ARTITULE/Stylophone_PCB/README.md

# Stylophone_PCB

A 20 key PCB Stylophone made using the 10 cent CH32V003 RISC-V microcontroller. It uses the FM8002A to amplify the signal to drive a small speaker. The whole thing is USB powered and functions like the real thing.

I made this to get better with audio circuits and also as a part of my week 3 submission to Half Life.

| Front Picture | Back Picture |
|---|---|
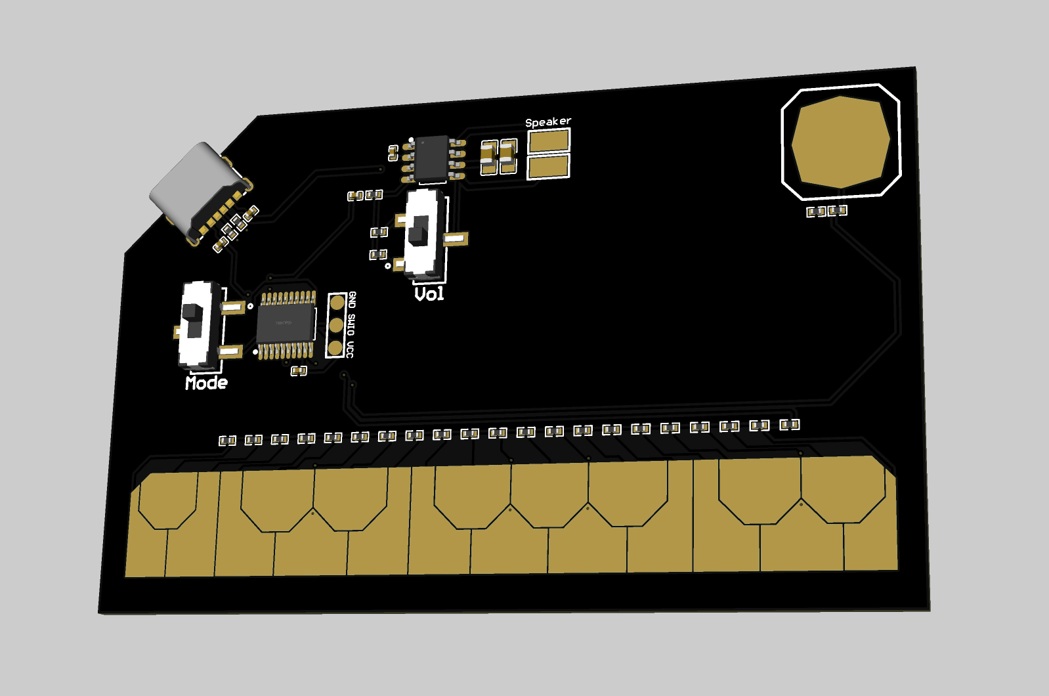
[picture p1: Pic/PCB_v1.0_Front.png]
front
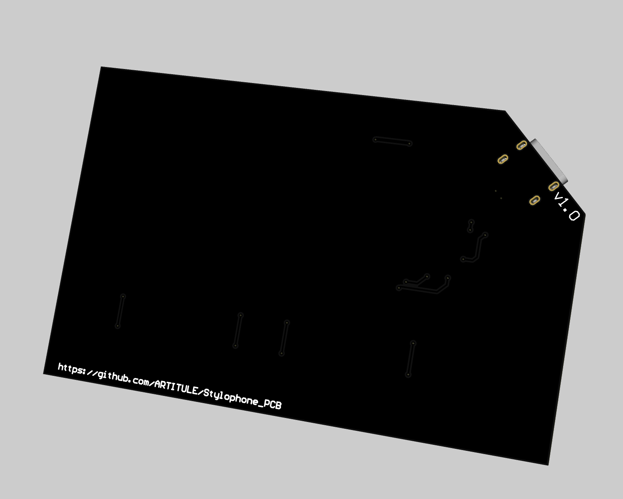
[picture p2: Pic/PCB_v1.0_Back.png]
back
|  |  |

## PCB Design

The PCB is a simple 2 Layer design. The project is powered with the Type-c USB port and uses the CH32V003 to read the key inputs and play audio accordingly. A resistor ladder is used to read all of the key presses. All of the parts are meant to be soldered to the PCB. All of the PCB files can be found in the [PCB_Files](/PCB_Files/) folder. There you can also find the BOM for the PCB.

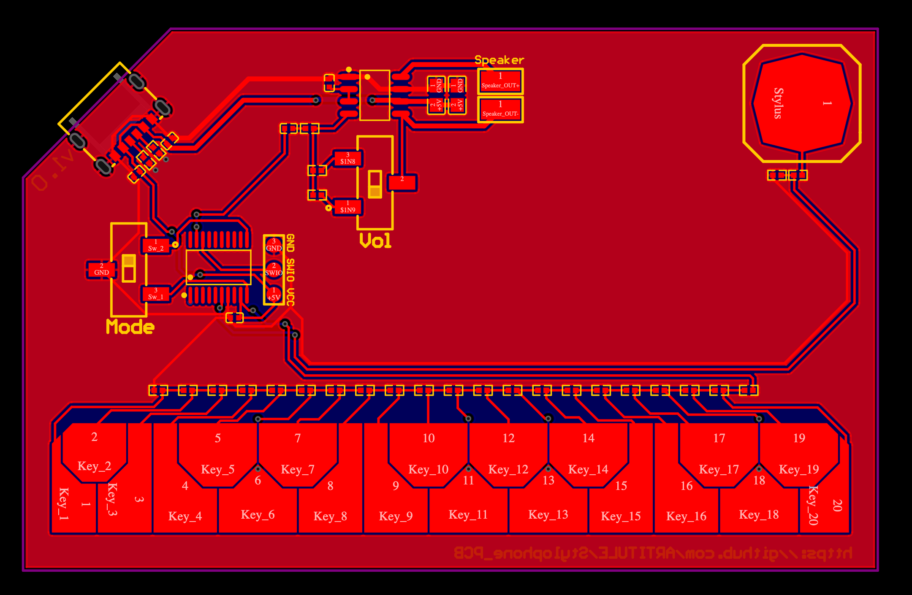
[picture p3: Pic/PCB_PCB1_2026-10-25.png]
PCB


For anyone interested here is the schematic:
Schematic

## Assembly

After soldering all of the SMD components to the PCB the last step is to solder the speaker to the two pads under the "Speaker" text.

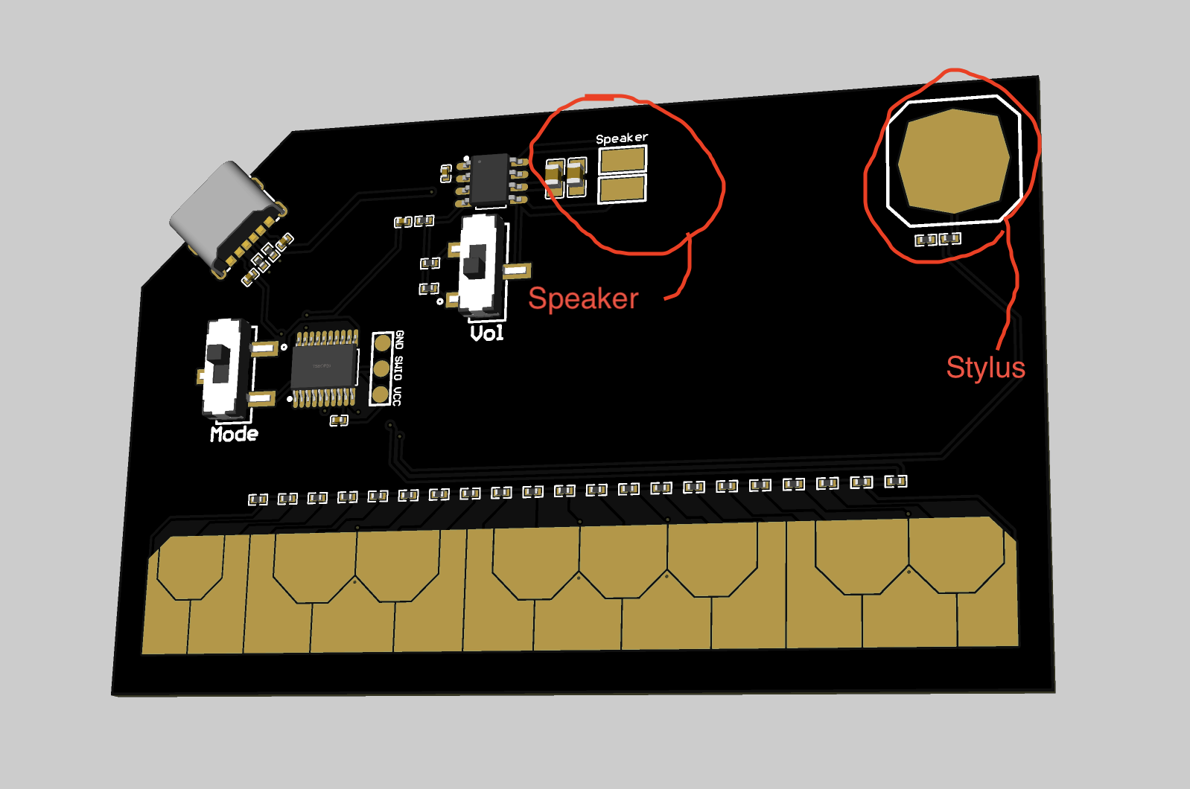
[picture p4: Pic/Speaker_Pointed.png]
speaker_pointed


After that just connect a crocodile clip or a stylus to the Stylus pad and enjoy!

## Firmware

One of the crystal pins has been used for the ADC function. Thankfully the PlatformIO Extension takes care of that and you can just upload the code.

All of the code is located in the [src folder](/src/).

## Installation

1. Clone or download the repository.
2. Initialize the PlatformIO extension.
3. Connect the WCH LINK-E programmer.
4. Select the "Stylophone_PCB" environment.
5. Upload the firmware and enjoy!

## BOM

Please note that the Shipping Price is an estimate and that the speaker/alligator clips have a minimum purchasing quantity.

|Item |Qty|Supplier|Cost/item |Total Cost|link |
|---|---|---|---|---|---|
|PCB |1  |JLCPCB  |$4.00 |$4.00 |[JLCPCB](https://jlcpcb.com) |
|SMD Components from LCSC(Please upload the PCB BOM to their website)|1  |LCSC |$11.09(Estimated)|$11.09 |[LCSC](https://www.lcsc.com) |
|8Ohm 2W Speaker (MOQ 6) |6  |Amazon  |$5.99 |$5.99 |[Amazon](https://www.amazon.com/Speaker-Speakers-Compatible-Loudspeaker-Player/dp/B09YGDQV3Z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) |
|Alligator Clips (MOQ 10) |10 |Amazon  |$4.99 |$4.99 |[Amazon](https://www.amazon.com/Alligator-Electrical-Crocodile-Connector-Connection/dp/B096S2JXYW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)|
|Estimated total shipping |1  | | |$20.00 | |
|Estimated TOTAL | | | |$46.07 | |
