ARTITULE/Stylophone_PCB/Pic/3D_Stylophone_PCB_v1.0_Front.png

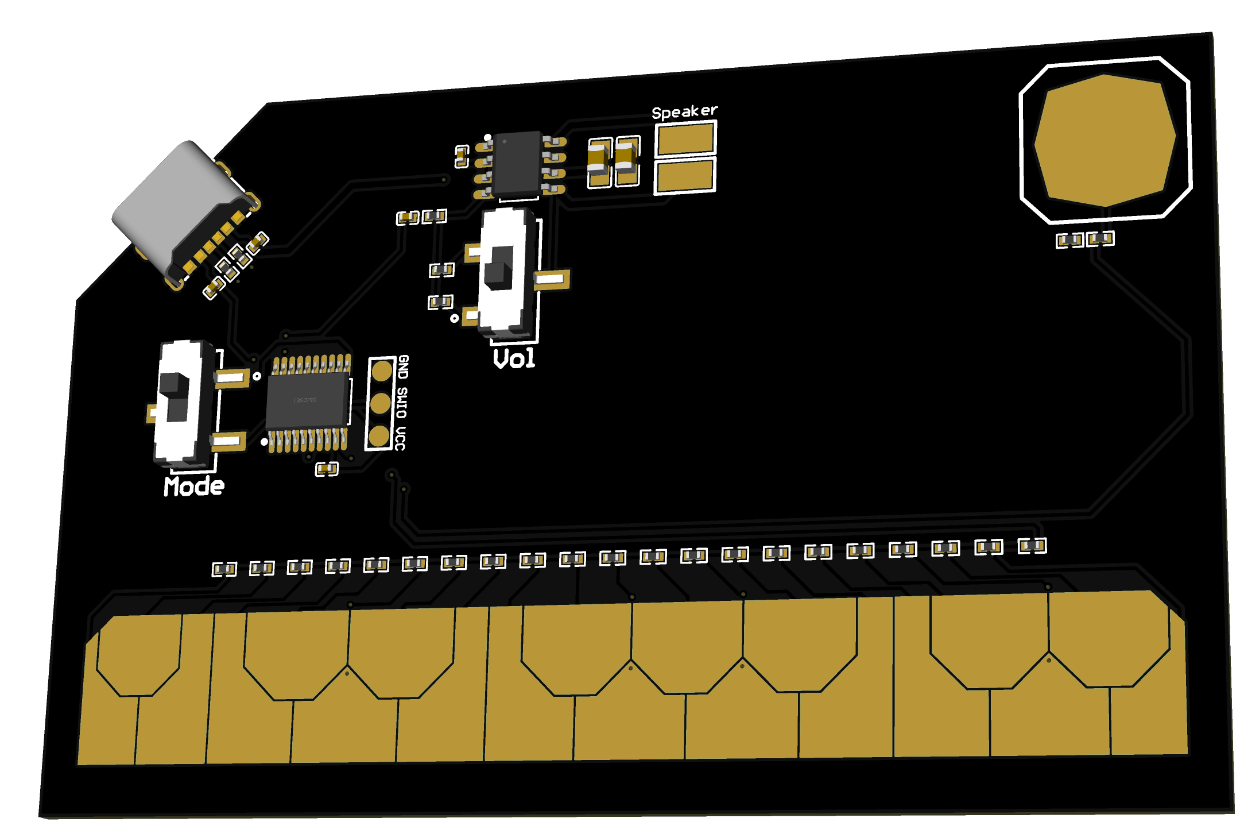
Pic/3D_Stylophone_PCB_v1.0_Front.png
