ARTITULE/Stylophone_PCB/BOM.csv

Item | Qty | Supplier | Cost/item | Total Cost | link
PCB | 1 | JLCPCB | $4.00 | $4.00 | https://jlcpcb.com
SMD Components from LCSC(Please upload the PCB BOM to their website) | 1 | LCSC | $11.09(Estimated) | $11.09 | https://www.lcsc.com
8Ohm 2W Speaker (MOQ 6) | 6 | Amazon | $5.99 | $5.99 | https://www.amazon.com/Speaker-Speakers-Compatible-Loudspeaker-Player/dp/B09YGDQV3Z
Alligator Clips (MOQ 10) | 10 | Amazon | $4.99 | $4.99 | https://www.amazon.com/Alligator-Electrical-Crocodile-Connector-Connection/dp/B096S2JXYW
Estimated total shipping | 1 |  |  | $20.00
Estimated TOTAL |  |  |  | $46.07
