ARTITULE/Stylophone_PCB/PCB_Files/BOM_Main_PCB_Stylophone_PCB_v1.0.xlsx

No. | Quantity | Comment | Designator | Footprint | Value | Manufacturer Part | Manufacturer | Supplier Part | Supplier
1 | 2 | 100nF | C1,C6 | C0402 | 100nF | CL05B104KB54PNC | SAMSUNG(三星) | C307331 | LCSC
2 | 2 | 1uF | C2,C7 | C0402 | 1uF | CL05A105KP5NNNC | SAMSUNG(三星) | C14445 | LCSC
3 | 1 | 1uF | C3 | C0805 | 1uF | CL21B105KBFNNNE | SAMSUNG(三星) | C28323 | LCSC
4 | 1 | 22uF | C4 | C0805 | 22uF | CL21A226MAQNNNE | SAMSUNG(三星) | C45783 | LCSC
5 | 1 | 470nF | C5 | C0402 | 470nF | CL05A474KP5NNNC | SAMSUNG(三星) | C47339 | LCSC
6 | 1 | HDR-M_2.54_1x3P | H1 | Top side pads
7 | 1 | Stylophone Pads | P1 | Stylophone_Pads_Footprint
8 | 2 | 5.1kΩ | R1,R2 | R0402 | 5.1kΩ | 0402WGF5101TCE | UNI-ROYAL(厚声) | C25905 | LCSC
9 | 2 | 18kΩ | R3,R5 | R0402 | 18kΩ | 0402WGF1802TCE | UNI-ROYAL(厚声) | C25762 | LCSC
10 | 1 | 51kΩ | R4 | R0402 | 51kΩ | 0402WGF5102TCE | UNI-ROYAL(厚声) | C25794 | LCSC
11 | 1 | 1.6MΩ | R6 | R0402 | 1.6MΩ | 0402WGJ0165TCE | UNI-ROYAL(厚声) | C57065 | LCSC
12 | 22 | 1kΩ | R7,R8,R9,R10,R11,R12,R13,R14,R15,R16,R17,R18,R19,R20,R21,R22,R23,R24,R25,R26,R27,R28 | R0402 | 1kΩ | 0402WGF1001TCE | UNI-ROYAL(厚声) | C11702 | LCSC
13 | 2 | LSSAM12-V-T/R | SW1,SW2 | SW-SMD_LSSAM12-V-T-R |  | LSSAM12-V-T/R | Diptronics(圜达) | C495944 | LCSC
14 | 1 | CH32V003F4P6 | U1 | TSSOP-20_L6.5-W4.4-P0.65-LS6.4-BL |  | CH32V003F4P6 | WCH(南京沁恒) | C5187096 | LCSC
15 | 1 | FM8002A | U2 | SOP-8_L4.9-W3.9-P1.27-LS6.0-BL |  | FM8002A | FM(富满) | C94625 | LCSC
16 | 2 | Pad 2mmx4mm | U3,U4 | Pad2mmx4mm
17 | 1 | Big_Pad_5x5mm | U5 | Big_Pad_5x5mm
18 | 1 | USB4125-GF-A | USB1 | USB-C-SMD_TYPE-C-6P |  | USB4125-GF-A | GCT | C3151650 | LCSC
