ARTITULE/Stylophone_PCB/PCB_Files/Schematic.pdf

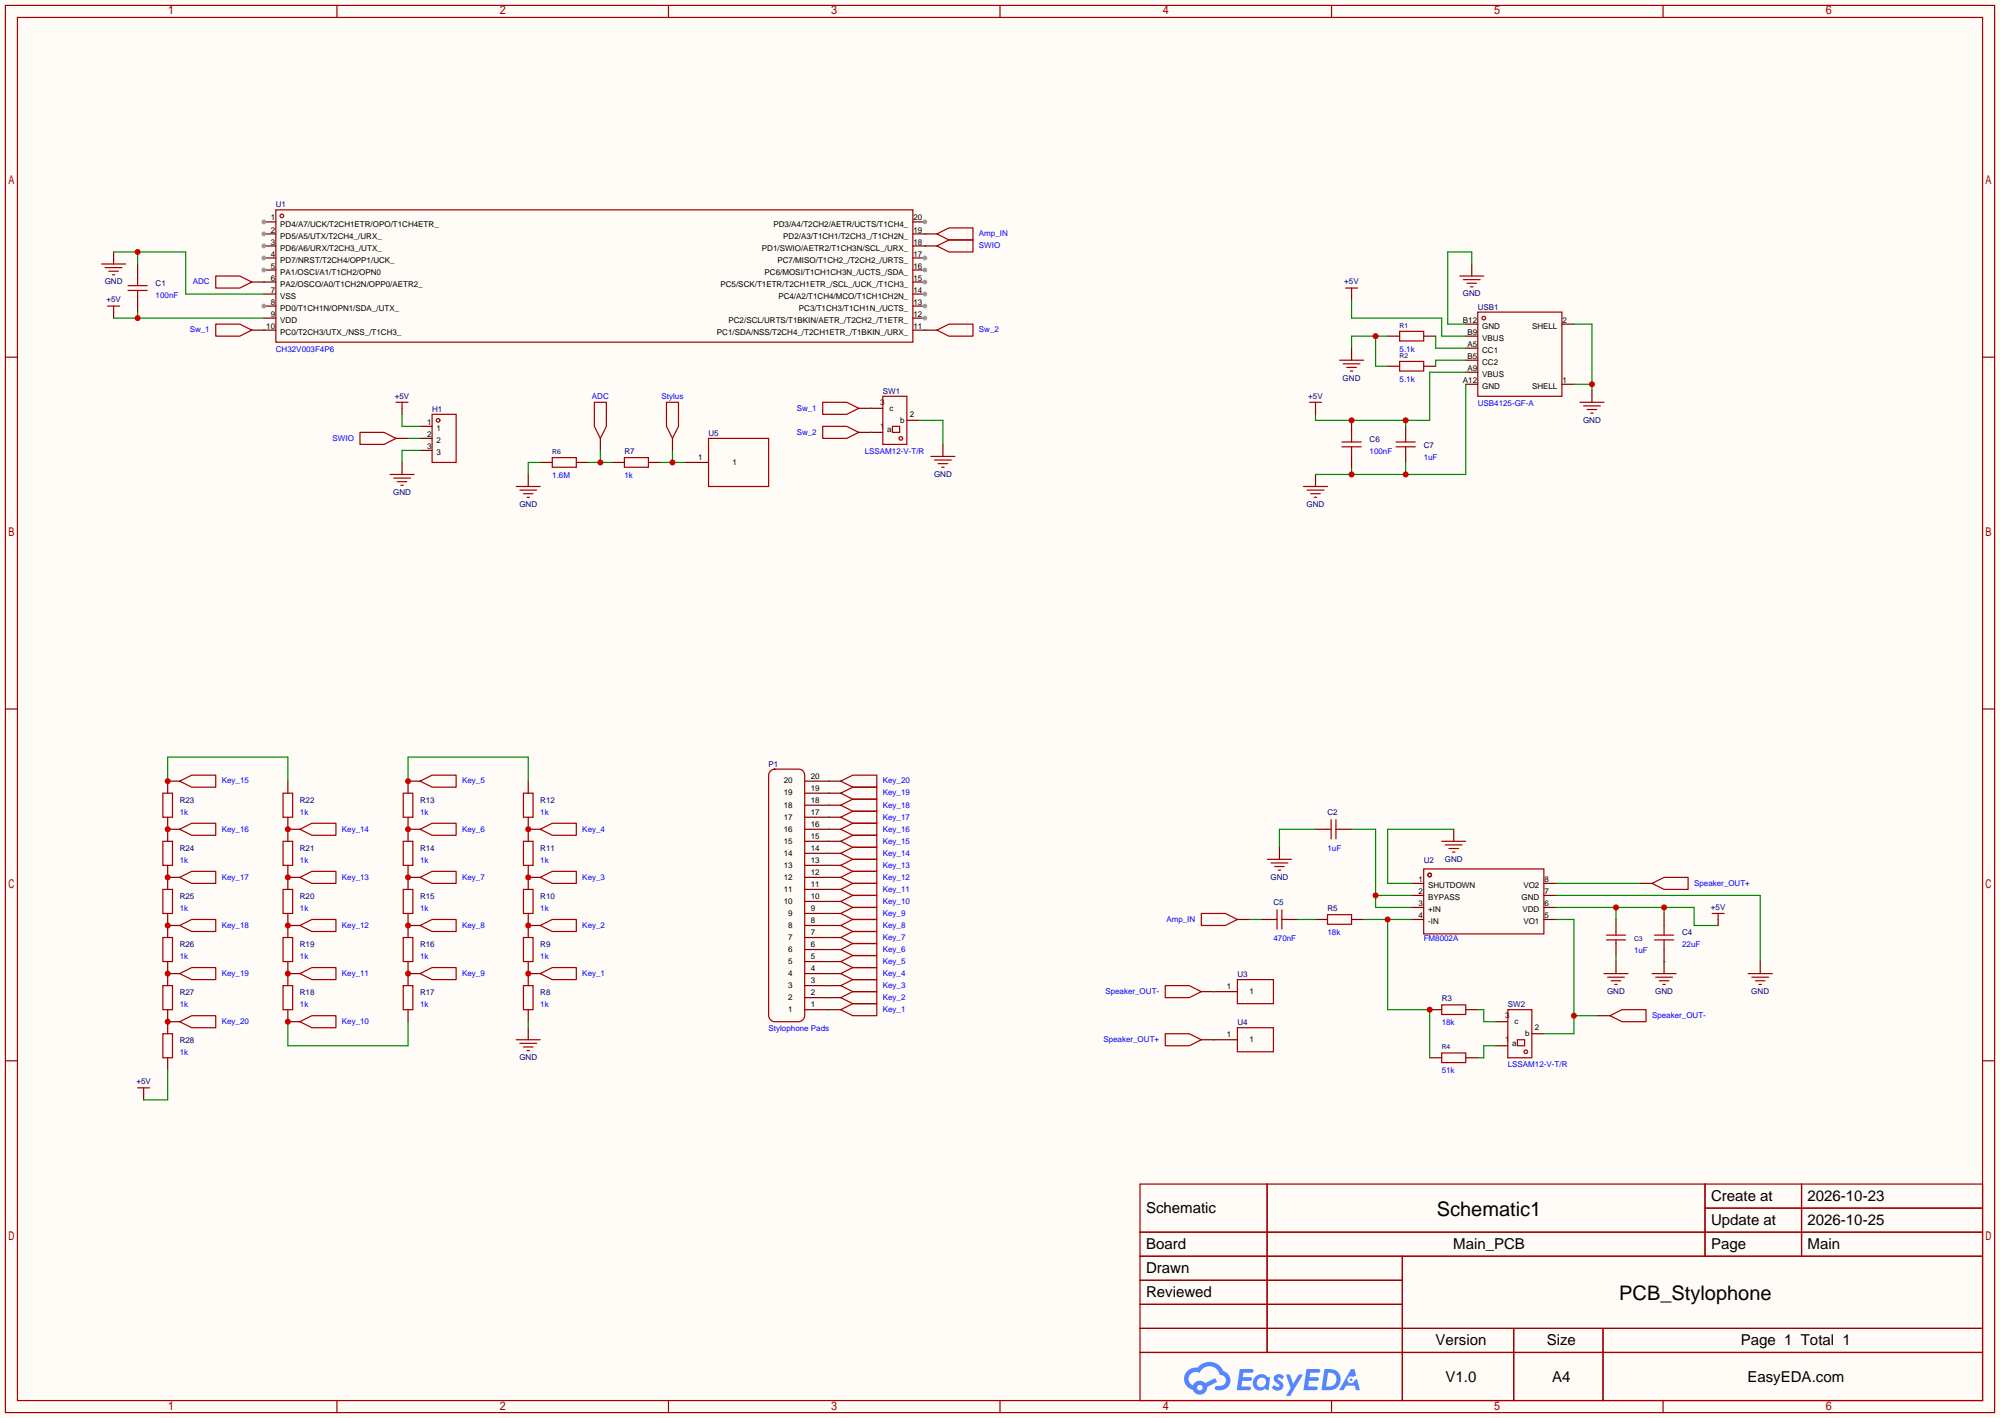
[picture p6: page 1]

Schematic | Schematic1 | Create at | 2026-10-23

Update at | 2026-10-25

Board | Main_PCB | Page | Main
Drawn | | PCB_Stylophone
Reviewed

Version | Size | Page 1 Total 1
V1.0 | A4 | EasyEDA.com
