ARTITULE/Stylophone_PCB/(list of files, drawings)

Other design files:
PCB_Files/Altium_Designer_Files/PCB1.pcbdoc
PCB_Files/Altium_Designer_Files/Schematic1/Main.schdoc
