ARTITULE/Stylophone_PCB/JOURNAL.md

# Stylophone PCB – devlog

<!-- Generated by Half Life from project cmvfhm993000q01o8qniu5q5a. Edits here are overwritten on the next sync. -->
<!-- Generated: 2026-10-25T16:28:51.692Z -->

> [!NOTE]
> This devlog is mirrored from [Half Life](https://halflife.hackclub.com) – [open the project](https://halflife.hackclub.com/projects/cmvfhm993000q01o8qniu5q5a). Editing it here will not change the platform's copy, and the next sync overwrites this file.

> A 20 key PCB Stylophone made using the 10 cent CH32V003 RISC-V microcontroller. It uses the FM8002A to amplify the signal to drive a small speaker. The whole thing is USB powered and functions like the real thing.

| Week | Tier | Hours logged | Entries |
| --- | --- | --- | --- |
| Week 3 | Tier 1 | 5.72h | 2 |

## Contents

1. [2026-10-25 – First entry,](#2026-10-25-first-entry)
2. [2026-10-25 – Second entry,](#2026-10-25-second-entry)

## Design

### 2026-10-25 – First entry,

**5.47h**

First entry,

Started on the PCB design. Created the pad footprint. After that placed all of the needed components and started wiring. Continued with the stylus footprint. After that created the PCB outline and spread the components based on their groups, after placing all of them started routing. Added some text where it was needed and that's it!

[Timelapse](https://lookout.hackclub.com/api/media/e80b073b-718e-474e-8b23-8b242b1af971/video.mp4)

### 2026-10-25 – Second entry,

**0.25h**

Second entry,

Started with changing the Schematic page size. After that started exporting all of the needed files. The Schematic, Gerber, BOM, Pick and place. And of course all of the pictures alongside the PCB Project file. And that's it!

[Timelapse](https://lookout.hackclub.com/api/media/4bb44d1e-39b1-4f14-ba0e-b546b0b9c4fd/video.mp4)
