ARTITULE/Stylophone_PCB/src/config.h

#define NUM_KEYS 20

const uint16_t noteFrequencies[20] = {
    220,  // A3
    233,  // A#3
    247,  // B3
    262,  // C4
    277,  // C#4
    294,  // D4
    311,  // D#4
    330,  // E4
    349,  // F4
    370,  // F#4
    392,  // G4
    415,  // G#4
    440,  // A4
    466,  // A#4
    494,  // B4
    523,  // C5
    554,  // C#5
    587,  // D5
    622,  // D#5
    659   // E5
};
