ARTITULE/Stylophone_PCB/(commit log)

2026-10-25 Add PCB Files
    [BOM_Main_PCB_Stylophone_PCB_v1.0.xlsx, PickAndPlace_Stylophone_PCB_v1_0.xlsx]
2026-10-25 Add Half Life BOM
    [BOM.csv]
2026-10-25 Sync Stylophone PCB from Half Life
    [BOM.csv]
2026-10-25 Update Half Life BOM
    [BOM.csv]
2026-10-25 Rename Schematic
2026-10-25 Move Schematic and Project files
2026-10-26 Add .epro2 Schematic
2026-10-26 Add another Schematic file
    [Schematic.schdoc]
2026-10-26 Add Altium Files
    [Main.schdoc, PCB1.pcbdoc]
